mcmsb/VolvoV50BT/Hardware/SpacePics/PXL_20231002_165956831.jpg

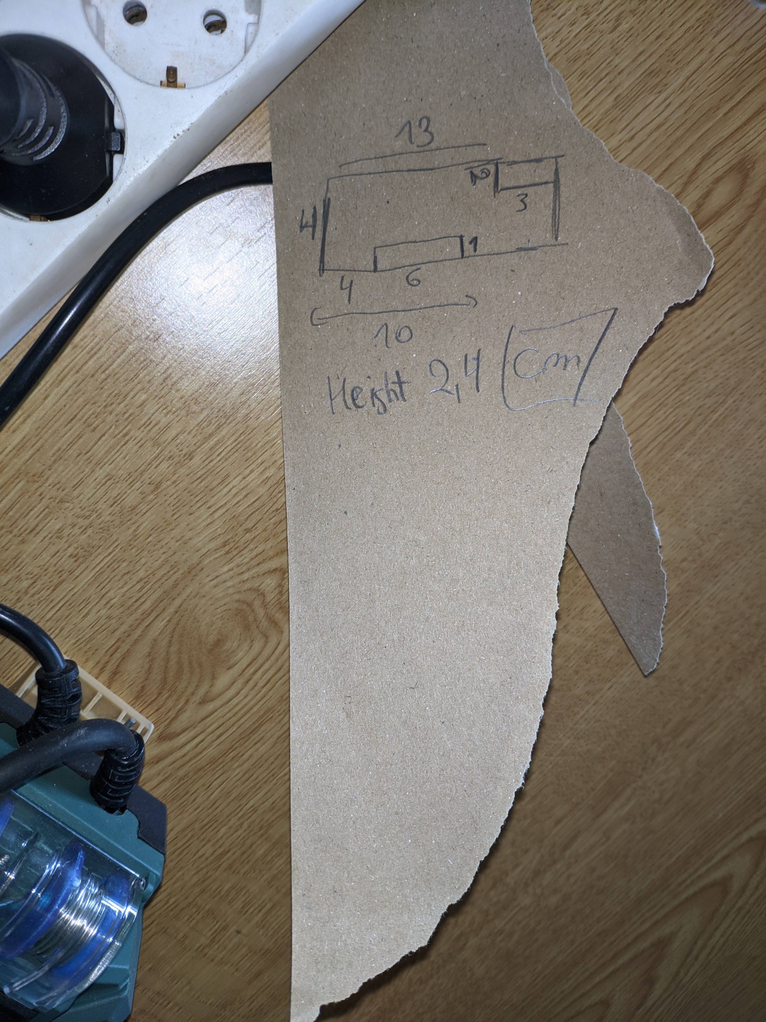
Hardware/SpacePics/PXL_20231002_165956831.jpg
