mcmsb/VolvoV50BT/Hardware/SpacePics/PXL_20231002_165637700.jpg

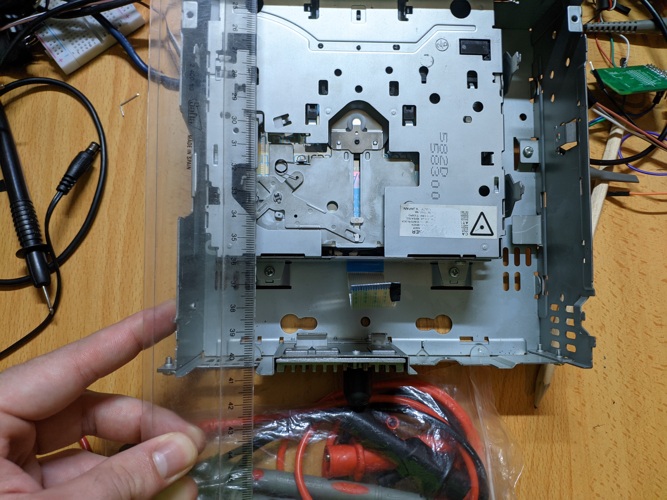
Hardware/SpacePics/PXL_20231002_165637700.jpg
