mcmsb/VolvoV50BT/Docs/BlockDiagram.drawio.png

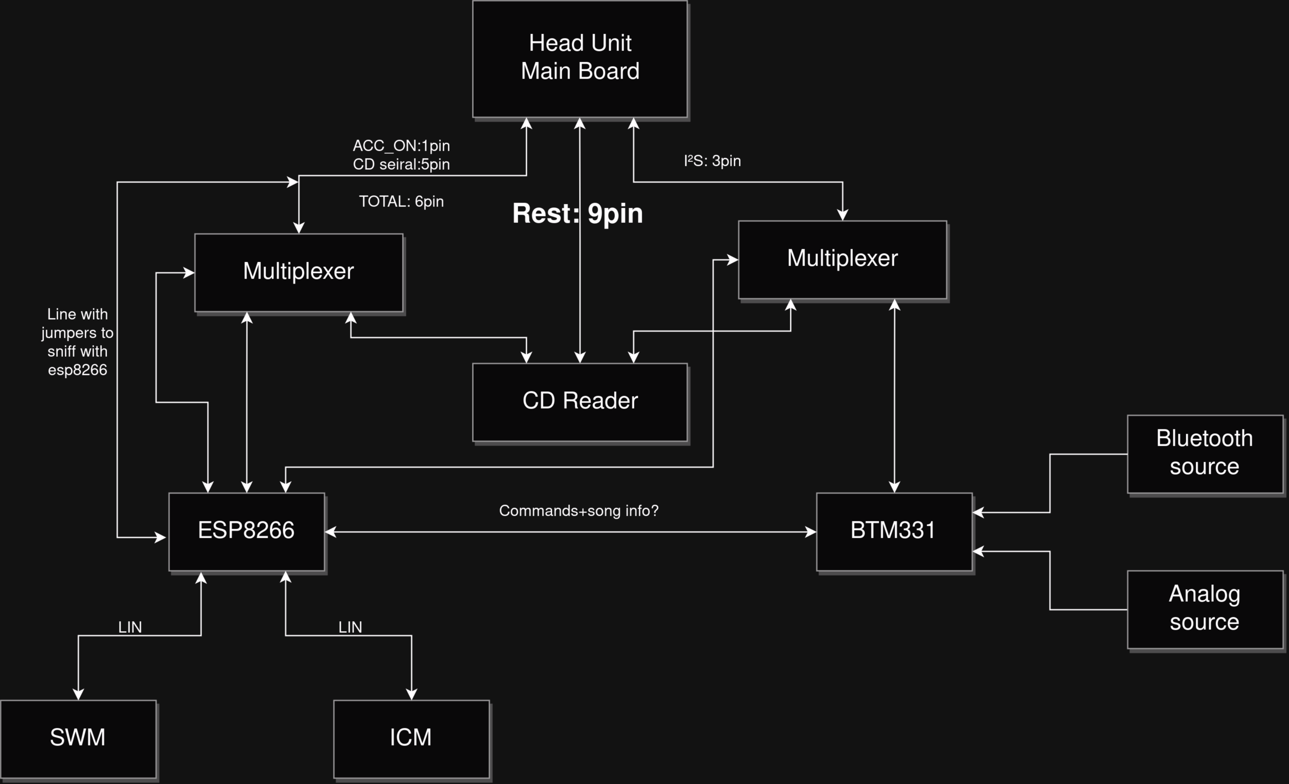
Docs/BlockDiagram.drawio.png
