mcmsb/VolvoV50BT/Docs/BlockDiagram_V0.1.png

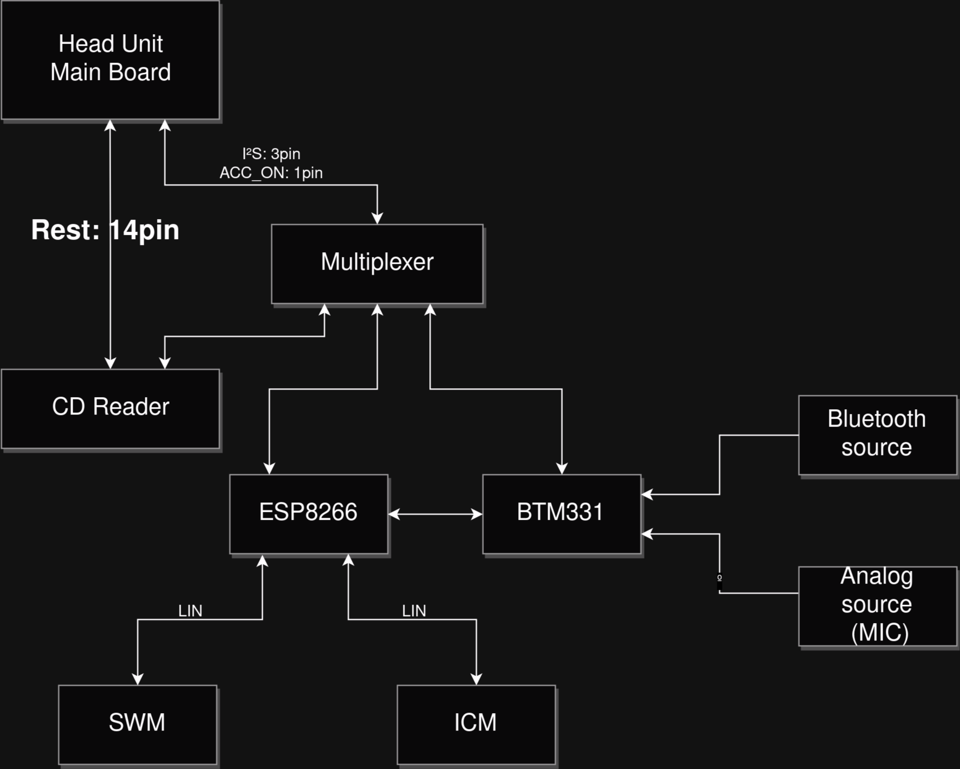
Docs/BlockDiagram_V0.1.png
