mcmsb/VolvoV50BT/Hardware/SpacePics/PXL_20231002_165643454.jpg

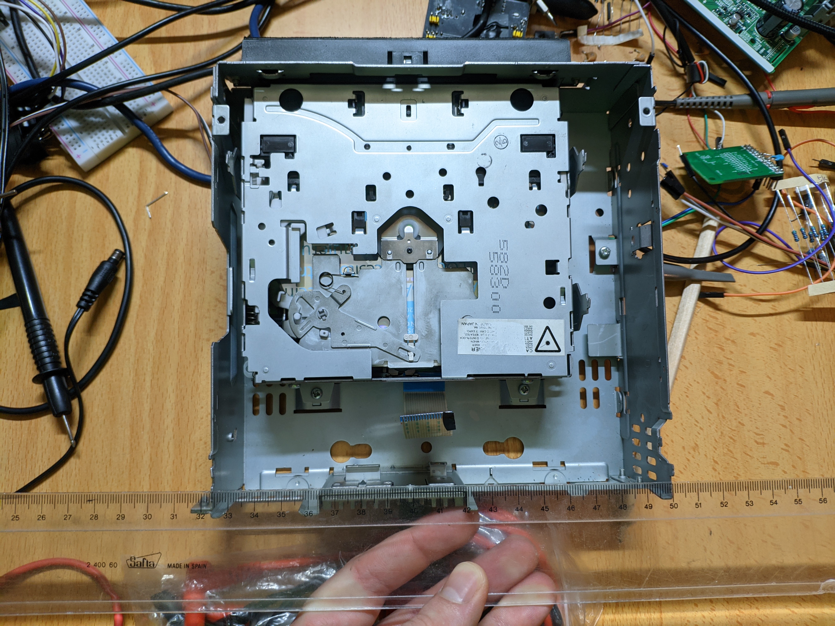
Hardware/SpacePics/PXL_20231002_165643454.jpg
