mcmsb/VolvoV50BT/Hardware/SpacePics/PXL_20231002_165909562.jpg

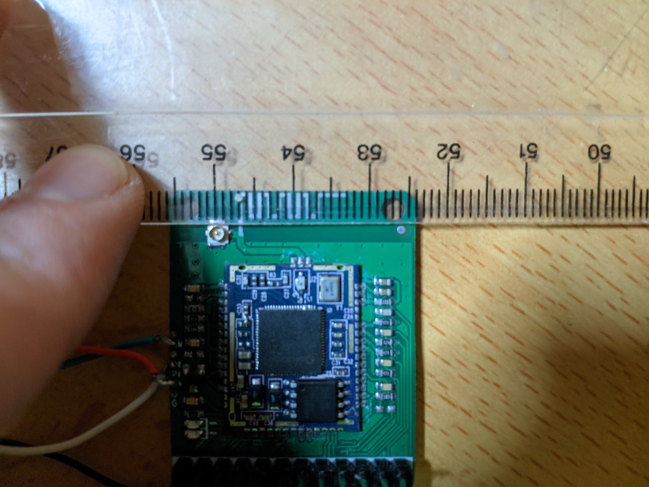
Hardware/SpacePics/PXL_20231002_165909562.jpg
