mcmsb/VolvoV50BT/Hardware/SpacePics/PXL_20231002_165921469.jpg

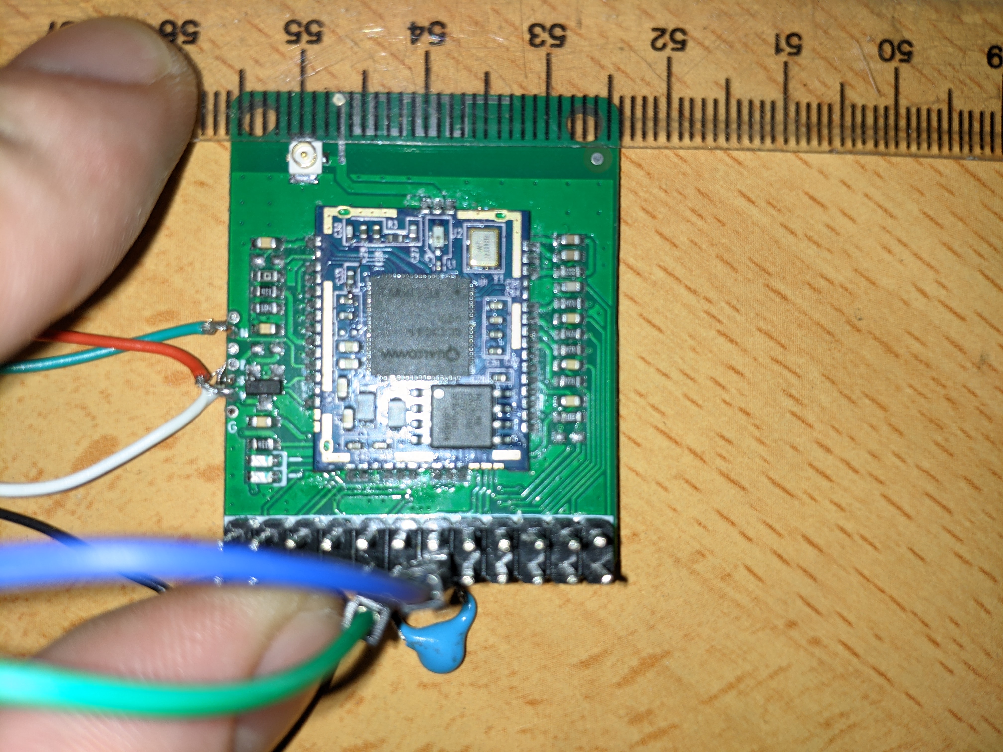
Hardware/SpacePics/PXL_20231002_165921469.jpg
