mcmsb/VolvoV50BT/(list of files, drawings)

Other design files:
Hardware/freerouting.dsn
