mcmsb/VolvoV50BT/Hardware/VOLVOAUXBT.kicad_pcb

## KiCad design Hardware/VOLVOAUXBT.kicad_pcb (2023-11-03)

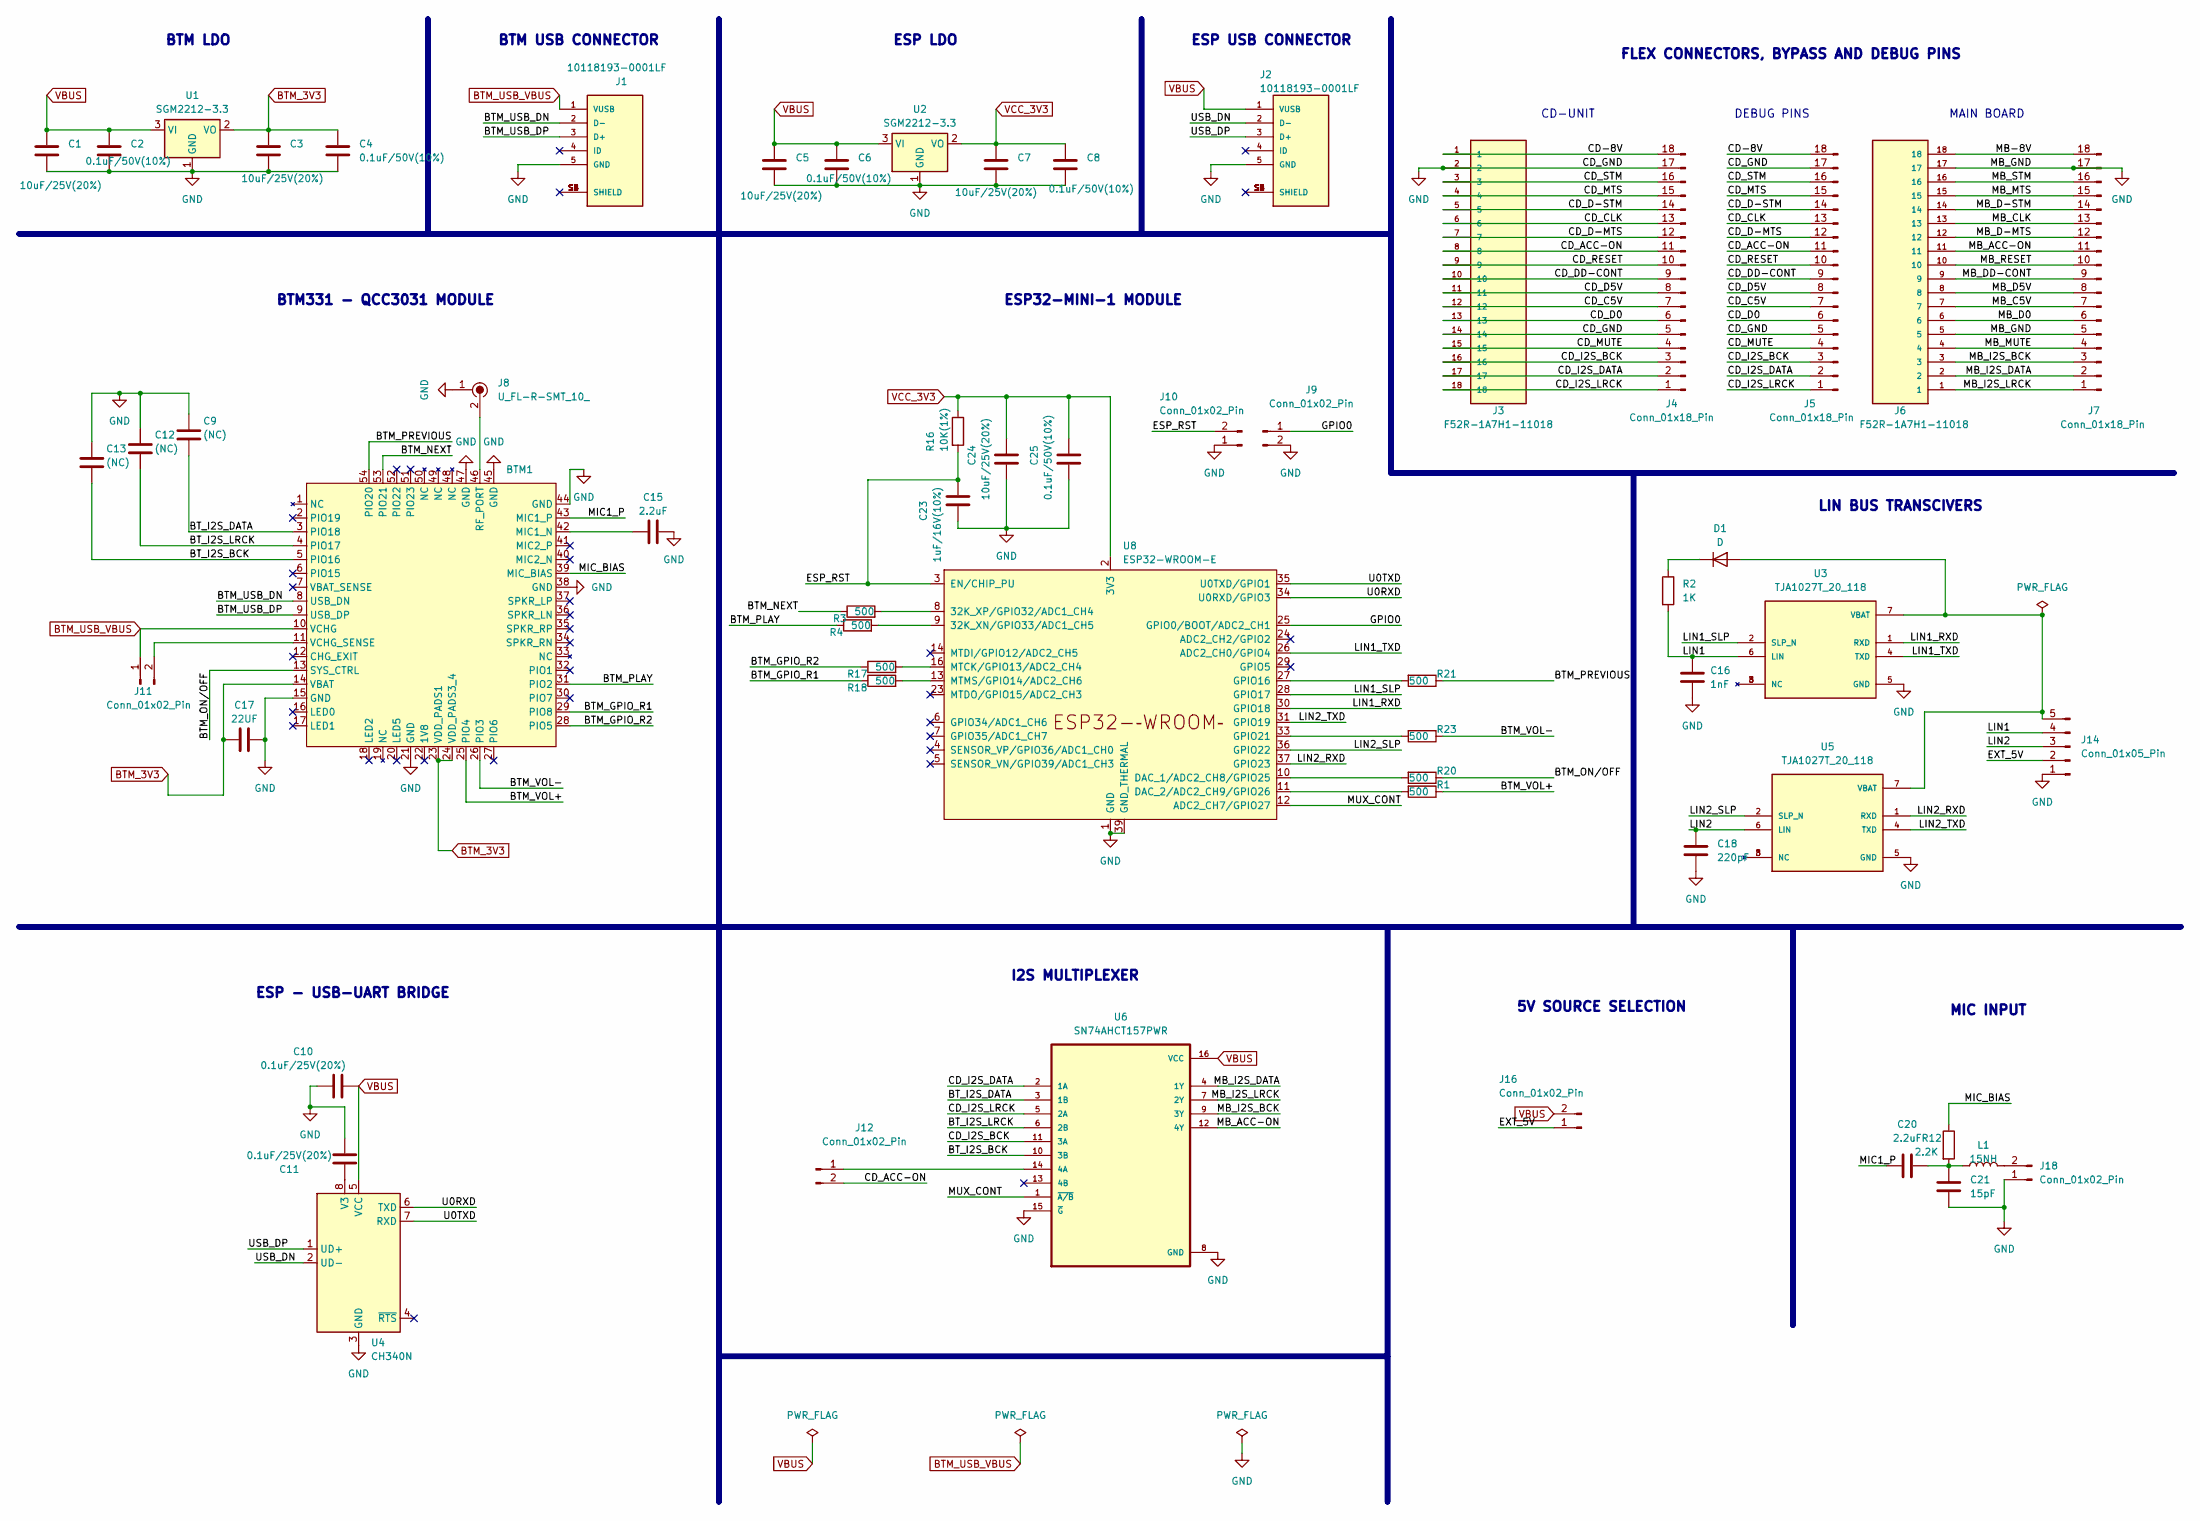
[picture p8: schematic VOLVOAUXBT.kicad_sch, Volvo P1 bluetooth MOD dev board]

Parts:
BTM1: BTM331
C1, C3, C5, C7, C24: 10uF/25V(20%); C_1206_3216Metric
C2, C4, C6, C8, C25: 0.1uF/50V(10%); C_1206_3216Metric
C9, C12, C13: (NC); C_1206_3216Metric_Pad1.33x1.80mm_HandSolder
C10, C11: 0.1uF/25V(20%); C_1206_3216Metric
C15, C20: 2.2uF; C_0805_2012Metric
C16: 1nF; C_1206_3216Metric_Pad1.33x1.80mm_HandSolder
C17: 22UF; C_1206_3216Metric
C18: 220pF; C_1206_3216Metric_Pad1.33x1.80mm_HandSolder
C21: 15pF; C_0603_1608Metric
C23: 1uF/16V(10%); C_1206_3216Metric
D1: D; D_1206_3216Metric
J1, J2: 10118193-0001LF; AMPHENOL_10118193-0001LF; PARTREV E
J3, J6: F52R-1A7H1-11018; AMPHENOL_F52R-1A7H1-11018; PARTREV B
J4, J5, J7: Conn_01x18_Pin; PinHeader_1x18_P2.54mm_Vertical
J8: U_FL-R-SMT_10_; U.FL_Hirose_U.FL-R-SMT-1_Vertical; MPN U.FL-R-SMT(10); Digi-Key_PN H9161CT-ND
J9, J10, J11, J12, J16, J18: Conn_01x02_Pin; PinHeader_1x02_P2.54mm_Vertical
J14: Conn_01x05_Pin; JST_XH_B5B-XH-AM_1x05_P2.50mm_Vertical
L1: 15NH; L_1206_3216Metric_Pad1.22x1.90mm_HandSolder
R1, R3, R4, R17, R18, R20, R21, R23: 500; R_0603_1608Metric
R2: 1K; R_0603_1608Metric
R12: 2.2K; R_0603_1608Metric
R16: 10K(1%); R_0603_1608Metric
U1, U2: SGM2212-3.3; SOT-223-3_TabPin2
U3, U5: TJA1027T_20_118; SOIC127P600X175-8N
U4: CH340N; SOP-8_3.9x4.9mm_P1.27mm
U6: SN74AHCT157PWR; SOP65P640X120-16N
U8: ESP32-WROOM-E; ESP32-WROOM-32E

Connections:
/BTM_GPIO_R1: BTM1.29 (PIO8), R18.1
/BTM_GPIO_R2: BTM1.28 (PIO5), R17.1
/BTM_NEXT: BTM1.53 (PIO21), R3.1
/BTM_ON/OFF: BTM1.13 (SYS_CTRL), R20.1
/BTM_PLAY: BTM1.31 (PIO2), R4.1
/BTM_PREVIOUS: BTM1.54 (PIO20), R21.1
/BTM_USB_DN: BTM1.8 (USB_DN), J1.2 (D-)
/BTM_USB_DP: BTM1.9 (USB_DP), J1.3 (D+)
/BTM_VOL+: BTM1.25 (PIO4), R1.1
/BTM_VOL-: BTM1.26 (PIO3), R23.1
/BT_I2S_BCK: BTM1.5 (PIO16), C13.2, U6.10 (3B)
/BT_I2S_DATA: BTM1.3 (PIO18), C9.2, U6.3 (1B)
/BT_I2S_LRCK: BTM1.4 (PIO17), C12.2, U6.6 (2B)
/CD-8V: J3.1, J4.18, J5.18
/CD_ACC-ON: J3.8, J4.11, J5.11, J12.2
/CD_C5V: J3.12, J4.7, J5.7
/CD_CLK: J3.6, J4.13, J5.13
/CD_D0: J3.13, J4.6, J5.6
/CD_D5V: J3.11, J4.8, J5.8
/CD_D-MTS: J3.7, J4.12, J5.12
/CD_D-STM: J3.5, J4.14, J5.14
/CD_DD-CONT: J3.10, J4.9, J5.9
/CD_I2S_BCK: J3.16, J4.3, J5.3, U6.11 (3A)
/CD_I2S_DATA: J3.17, J4.2, J5.2, U6.2 (1A)
/CD_I2S_LRCK: J3.18, J4.1, J5.1, U6.5 (2A)
/CD_MTS: J3.4, J4.15, J5.15
/CD_MUTE: J3.15, J4.4, J5.4
/CD_RESET: J3.9, J4.10, J5.10
/CD_STM: J3.3, J4.16, J5.16
/ESP_RST: C23.1, J10.2, R16.2, U8.3 (EN/CHIP_PU)
/EXT_5V: J14.2, J16.1
/GPIO0: J9.1, U8.25 (GPIO0/BOOT/ADC2_CH1)
/LIN1: C16.1, J14.4, R2.2, U3.6 (LIN)
/LIN1_RXD: U3.1 (RXD), U8.30 (GPIO18)
/LIN1_SLP: U3.2 (SLP_N), U8.28 (GPIO17)
/LIN1_TXD: U3.4 (TXD), U8.26 (ADC2_CH0/GPIO4)
/LIN2: C18.1, J14.3, U5.6 (LIN)
/LIN2_RXD: U5.1 (RXD), U8.37 (GPIO23)
/LIN2_SLP: U5.2 (SLP_N), U8.36 (GPIO22)
/LIN2_TXD: U5.4 (TXD), U8.31 (GPIO19)
/MB-8V: J6.18, J7.18
/MB_ACC-ON: J6.11, J7.11, U6.12 (4Y)
/MB_C5V: J6.7, J7.7
/MB_CLK: J6.13, J7.13
/MB_D0: J6.6, J7.6
/MB_D5V: J6.8, J7.8
/MB_D-MTS: J6.12, J7.12
/MB_D-STM: J6.14, J7.14
/MB_DD-CONT: J6.9, J7.9
/MB_I2S_BCK: J6.3, J7.3, U6.9 (3Y)
/MB_I2S_DATA: J6.2, J7.2, U6.4 (1Y)
/MB_I2S_LRCK: J6.1, J7.1, U6.7 (2Y)
/MB_MTS: J6.15, J7.15
/MB_MUTE: J6.4, J7.4
/MB_RESET: J6.10, J7.10
/MB_STM: J6.16, J7.16
/MIC1_P: BTM1.43 (MIC1_P), C20.1
/MIC_BIAS: BTM1.39 (MIC_BIAS), R12.1
/MUX_CONT: U6.1 (~A/B), U8.12 (ADC2_CH7/GPIO27)
/U0RXD: U4.6 (TXD), U8.34 (U0RXD/GPIO3)
/U0TXD: U4.7 (RXD), U8.35 (U0TXD/GPIO1)
/USB_DN: J2.2 (D-), U4.2 (UD-)
/USB_DP: J2.3 (D+), U4.1 (UD+)
BTM_3V3: BTM1.14 (VBAT), BTM1.23 (VDD_PADS1), BTM1.24 (VDD_PADS3_4), C3.1, C4.1, C17.1, U1.2 (VO)
BTM_USB_VBUS: BTM1.10 (VCHG), J1.1 (VUSB), J11.1
GND: BTM1.15 (GND), BTM1.21 (GND), BTM1.38 (GND), BTM1.44 (GND), BTM1.45 (GND), BTM1.47 (GND), C1.2, C2.2, C3.2, C4.2, C5.2, C6.2, C7.2, C8.2, C9.1, C10.1, C11.2, C12.1, C13.1, C15.2, C16.2, C17.2, C18.2, C21.2, C23.2, C24.2, C25.2, J1.5 (GND), J2.5 (GND), J3.2, J3.14, J4.5, J4.17, J5.5, J5.17, J6.5, J6.17, J7.5, J7.17, J8.1, J9.2, J10.1, J14.1, J18.1, U1.1 (GND), U2.1 (GND), U3.5 (GND), U4.3 (GND), U5.5 (GND), U6.8 (GND), U6.15 (~G), U8.1 (GND), U8.15 (GND), U8.38 (GND), U8.39 (GND_THERMAL)
unnamed: BTM1.42 (MIC1_N), C15.1
unnamed: BTM1.46 (RF_PORT), J8.2
unnamed: BTM1.11 (VCHG_SENSE), J11.2
unnamed: C20.2, C21.1, L1.1, R12.2
unnamed: D1.2 (A), J14.5, U3.7 (VBAT), U5.7 (VBAT)
unnamed: D1.1 (K), R2.1
unnamed: J12.1, U6.14 (4A)
unnamed: J18.2, L1.2
unnamed: C11.1, U4.8 (V3)
unnamed: R4.2, U8.9 (32K_XN/GPIO33/ADC1_CH5)
unnamed: R3.2, U8.8 (32K_XP/GPIO32/ADC1_CH4)
unnamed: R20.2, U8.10 (DAC_1/ADC2_CH8/GPIO25)
unnamed: R1.2, U8.11 (DAC_2/ADC2_CH9/GPIO26)
unnamed: R21.2, U8.27 (GPIO16)
unnamed: R23.2, U8.33 (GPIO21)
unnamed: R17.2, U8.16 (MTCK/GPIO13/ADC2_CH4)
unnamed: R18.2, U8.13 (MTMS/GPIO14/ADC2_CH6)
VBUS: C1.1, C2.1, C5.1, C6.1, C10.2, J2.1 (VUSB), J16.2, U1.3 (VI), U2.3 (VI), U4.5 (VCC), U6.16 (VCC)
VCC_3V3: C7.1, C8.1, C24.1, C25.1, R16.1, U2.2 (VO), U8.2 (3V3)

Notes on the sheet:
I2S MULTIPLEXER
BTM USB CONNECTOR
BTM LDO
5V SOURCE SELECTION
MIC INPUT
MAIN BOARD
ESP32-MINI-1 MODULE
ESP USB CONNECTOR
BTM331 - QCC3031 MODULE
CD-UNIT
ESP - USB-UART BRIDGE
LIN BUS TRANSCIVERS
DEBUG PINS
ESP LDO
FLEX CONNECTORS, BYPASS AND DEBUG PINS

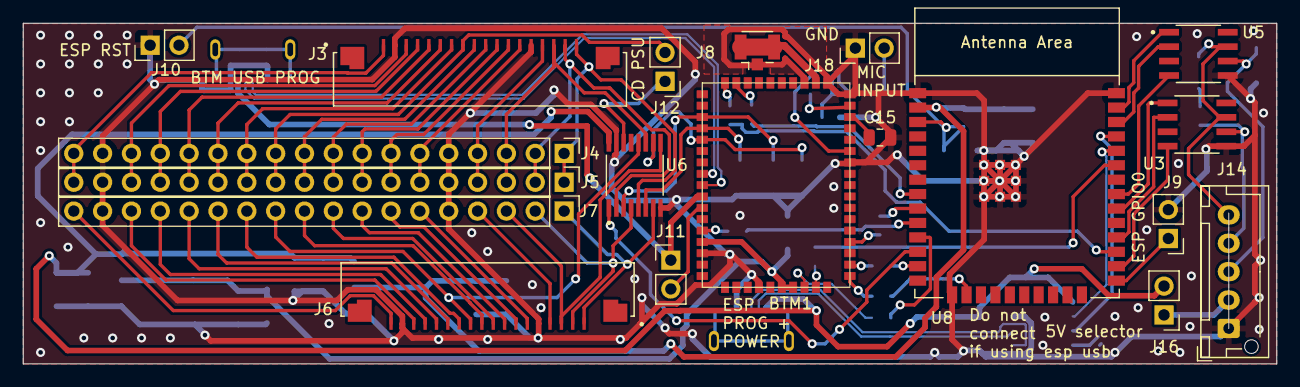
[picture p9: board VOLVOAUXBT.kicad_pcb from above]

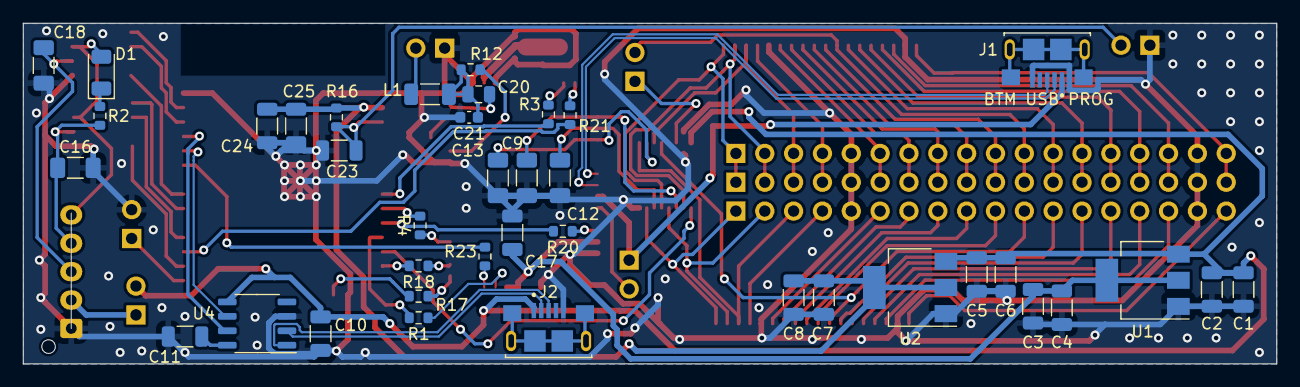
[picture p10: board VOLVOAUXBT.kicad_pcb from below]

Board: 2 copper layers, 110.4 x 30.0 mm, 58 parts (39 on the bottom side), 85 nets.
