mcmsb/VolvoV50BT/(commit log)

2023-10-01 Schematic V0.1 - No pcb
    [VOLVOAUXBT.kicad_pcb, VOLVOAUXBT.kicad_sch]
2023-10-02 PCB layout wihtout traces
    [VOLVOAUXBT.kicad_pcb, VOLVOAUXBT.kicad_sch, bom.csv, designators.csv, positions.csv]
2023-10-21 Before swap to wroom
    [VOLVOAUXBT.kicad_pcb, VOLVOAUXBT.kicad_sch, bom.csv, designators.csv, freerouting.dsn, positions.csv, temp-freerouting.dsn]
2023-10-21 Swap to ESP32-wroom-32e. Updated PCB too
    [VOLVOAUXBT.kicad_pcb]
2023-10-21 First iteration of PCB routing
    [VOLVOAUXBT.kicad_pcb, VOLVOAUXBT.kicad_sch, freerouting.dsn, temp-freerouting.dsn]
2023-10-22 Crappy routing, too cramped
    [VOLVOAUXBT.kicad_pcb, VOLVOAUXBT.kicad_sch]
2023-10-23 Routing with low side clearence. Pending accurate measurments for produciton
    [VOLVOAUXBT.kicad_pcb, VOLVOAUXBT.kicad_sch, bom.csv, designators.csv, positions.csv]
2023-11-03 XST set to 2.5mm. Swapping for 2.54mm
    [VOLVOAUXBT.kicad_pcb, VOLVOAUXBT.kicad_sch, bom-edit.csv, bom.csv, designators.csv, positions.csv]
